ahmadachaji123/Smart-Plug/Electric Schematic amd simulation/circuit simulation TinKerCad.png

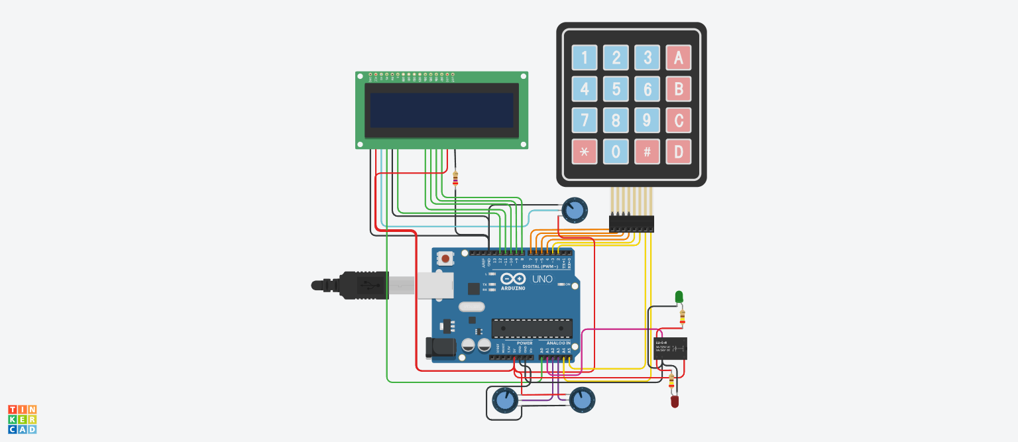
Electric Schematic amd simulation/circuit simulation TinKerCad.png
