ahmadachaji123/Smart-Plug/Electric Schematic amd simulation/simulation proteis.png

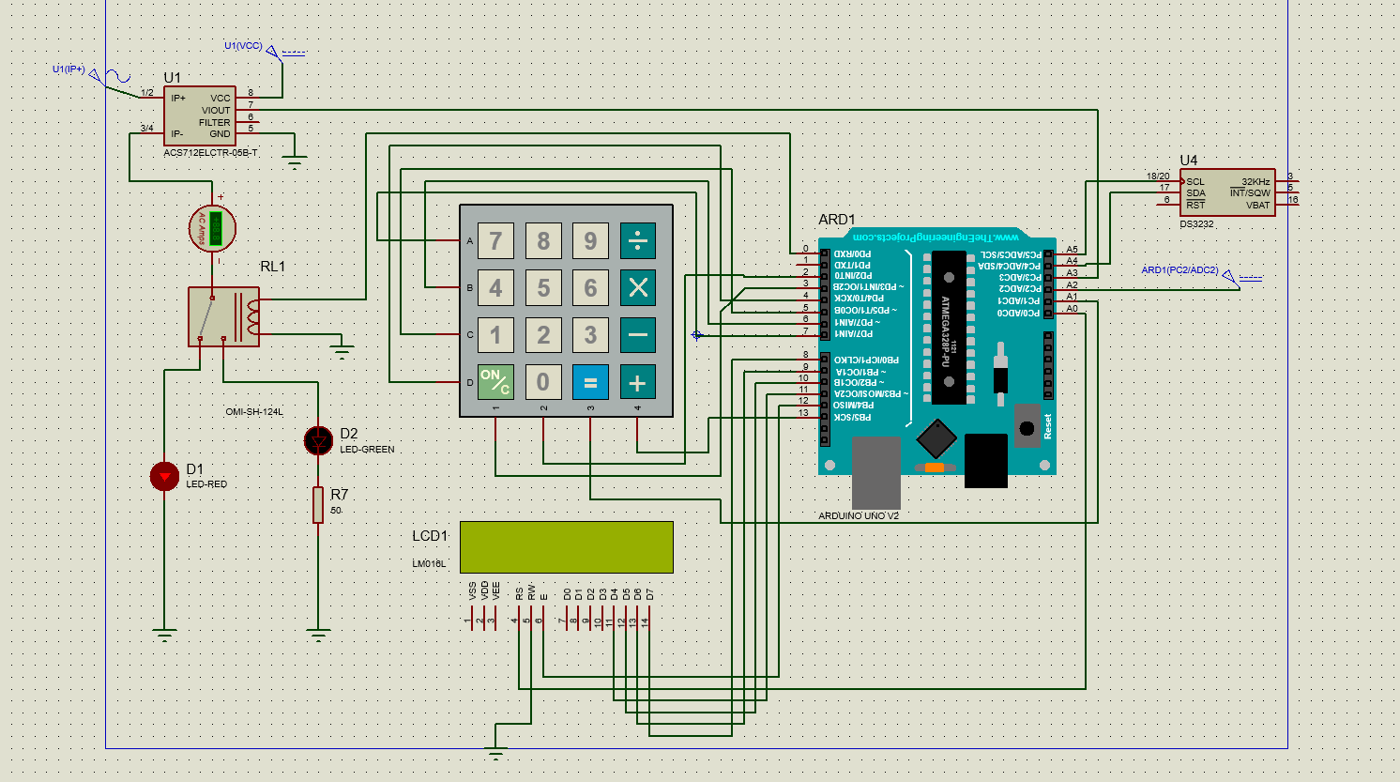
Electric Schematic amd simulation/simulation proteis.png
