ahmadachaji123/Smart-Plug/media/1 .png

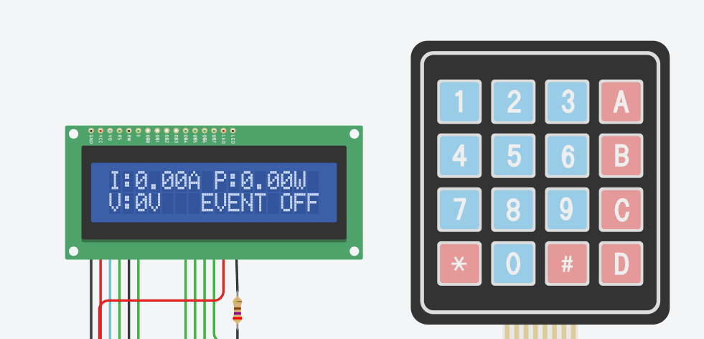
media/1 .png
