ahmadachaji123/Smart-Plug/media/2.png

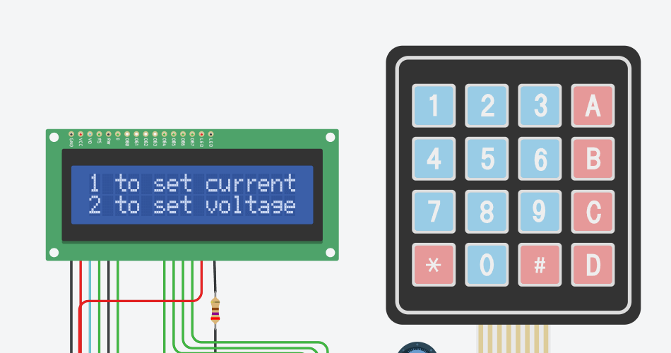
media/2.png
