ahmadachaji123/Smart-Plug/media/3.png

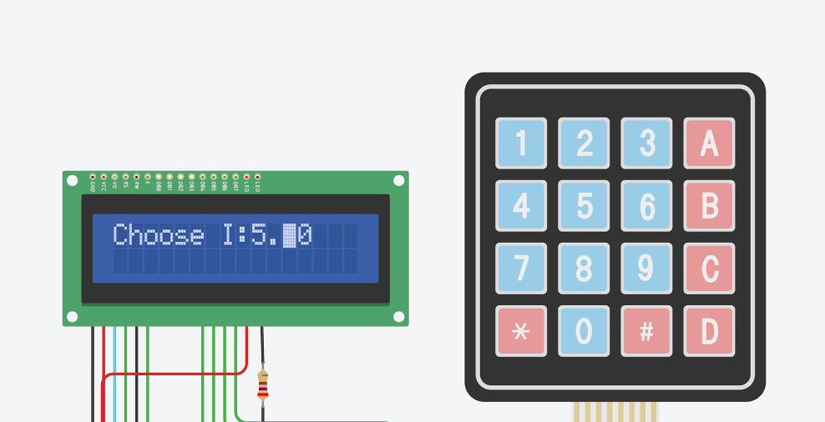
media/3.png
