ahmadachaji123/Smart-Plug/media/4.png

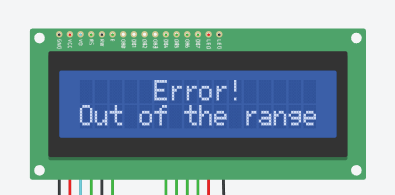
media/4.png
