ahmadachaji123/Smart-Plug/media/5.png

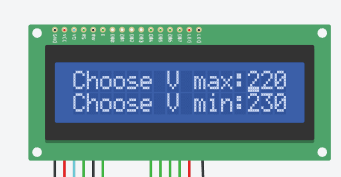
media/5.png
