ahmadachaji123/Smart-Plug/media/6.png

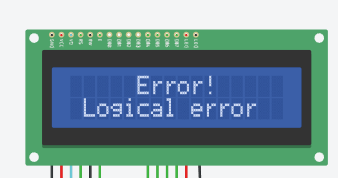
media/6.png
