ahmadachaji123/Smart-Plug/media/7.png

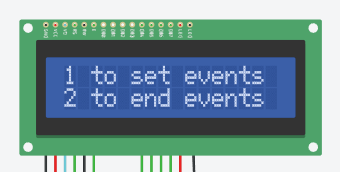
media/7.png
