ahmadachaji123/Smart-Plug/media/8.png

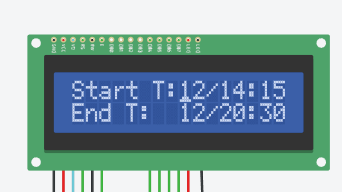
media/8.png
