ahmadachaji123/Smart-Plug/media/9- EVENT is ON .png

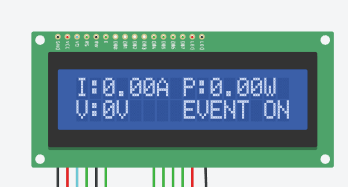
media/9- EVENT is ON .png
