ahmadachaji123/Smart-Plug/media/10 - event is off by pressing 2 break event .png

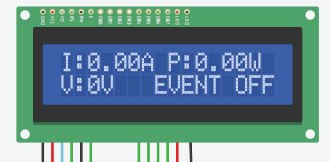
media/10 - event is off by pressing 2 break event .png
