ahmadachaji123/Smart-Plug/media/11 error events .png

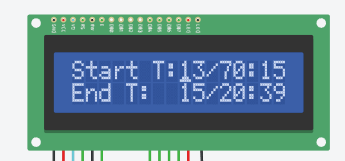
media/11 error events .png
