ahmadachaji123/Smart-Plug/media/12 error  events 1 .png

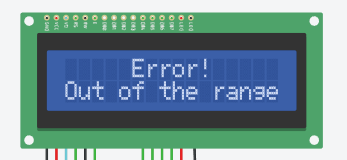
media/12 error events 1 .png
