ahmadachaji123/Smart-Plug/media/14 erro screen event 2 .png

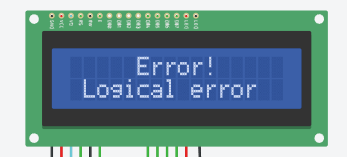
media/14 erro screen event 2 .png
