ahmadachaji123/Smart-Plug/Electric Schematic amd simulation/Electric Schematic.pdf

A

1 | 2 | 3 | 4 | 5 | 6

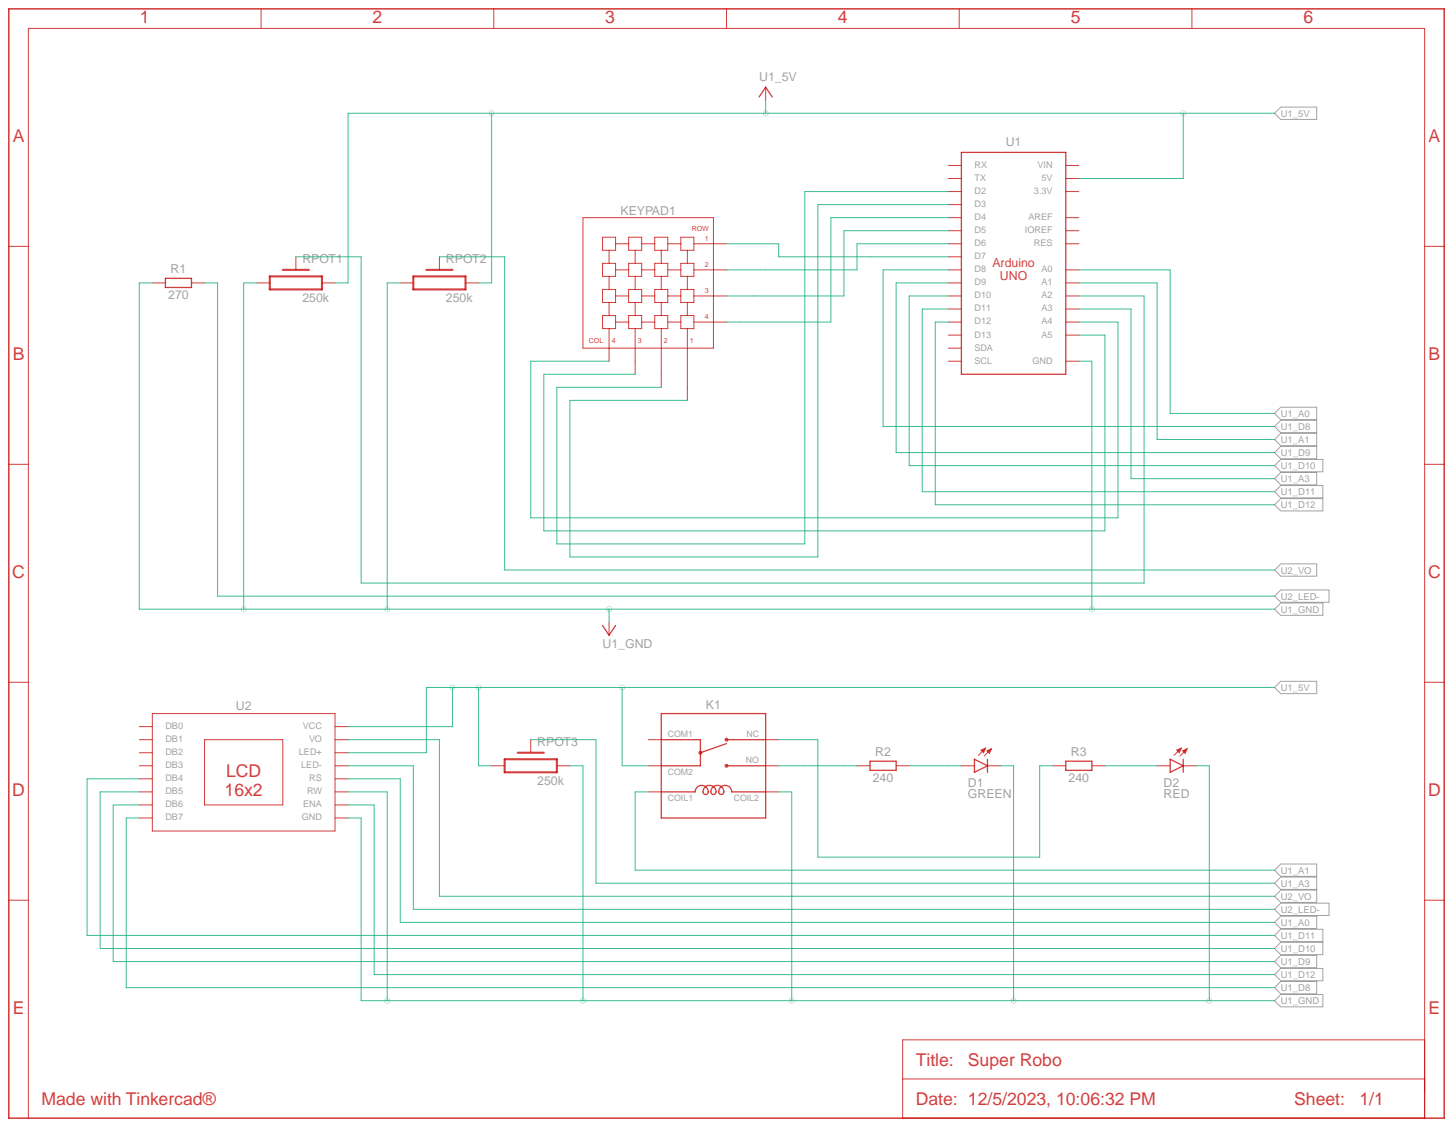
[picture p33: page 1]

COM2 | | 240 D1

COIL1 COIL2
