ahmadachaji123/Smart-Plug/(list of files, drawings)

Other design files:
Electric Schematic amd simulation/proteus 8 main simulation/main simulation.pdsprj
